Facundo-prog/CPU_sin_procesador/documentation/circuit diagram.pdf

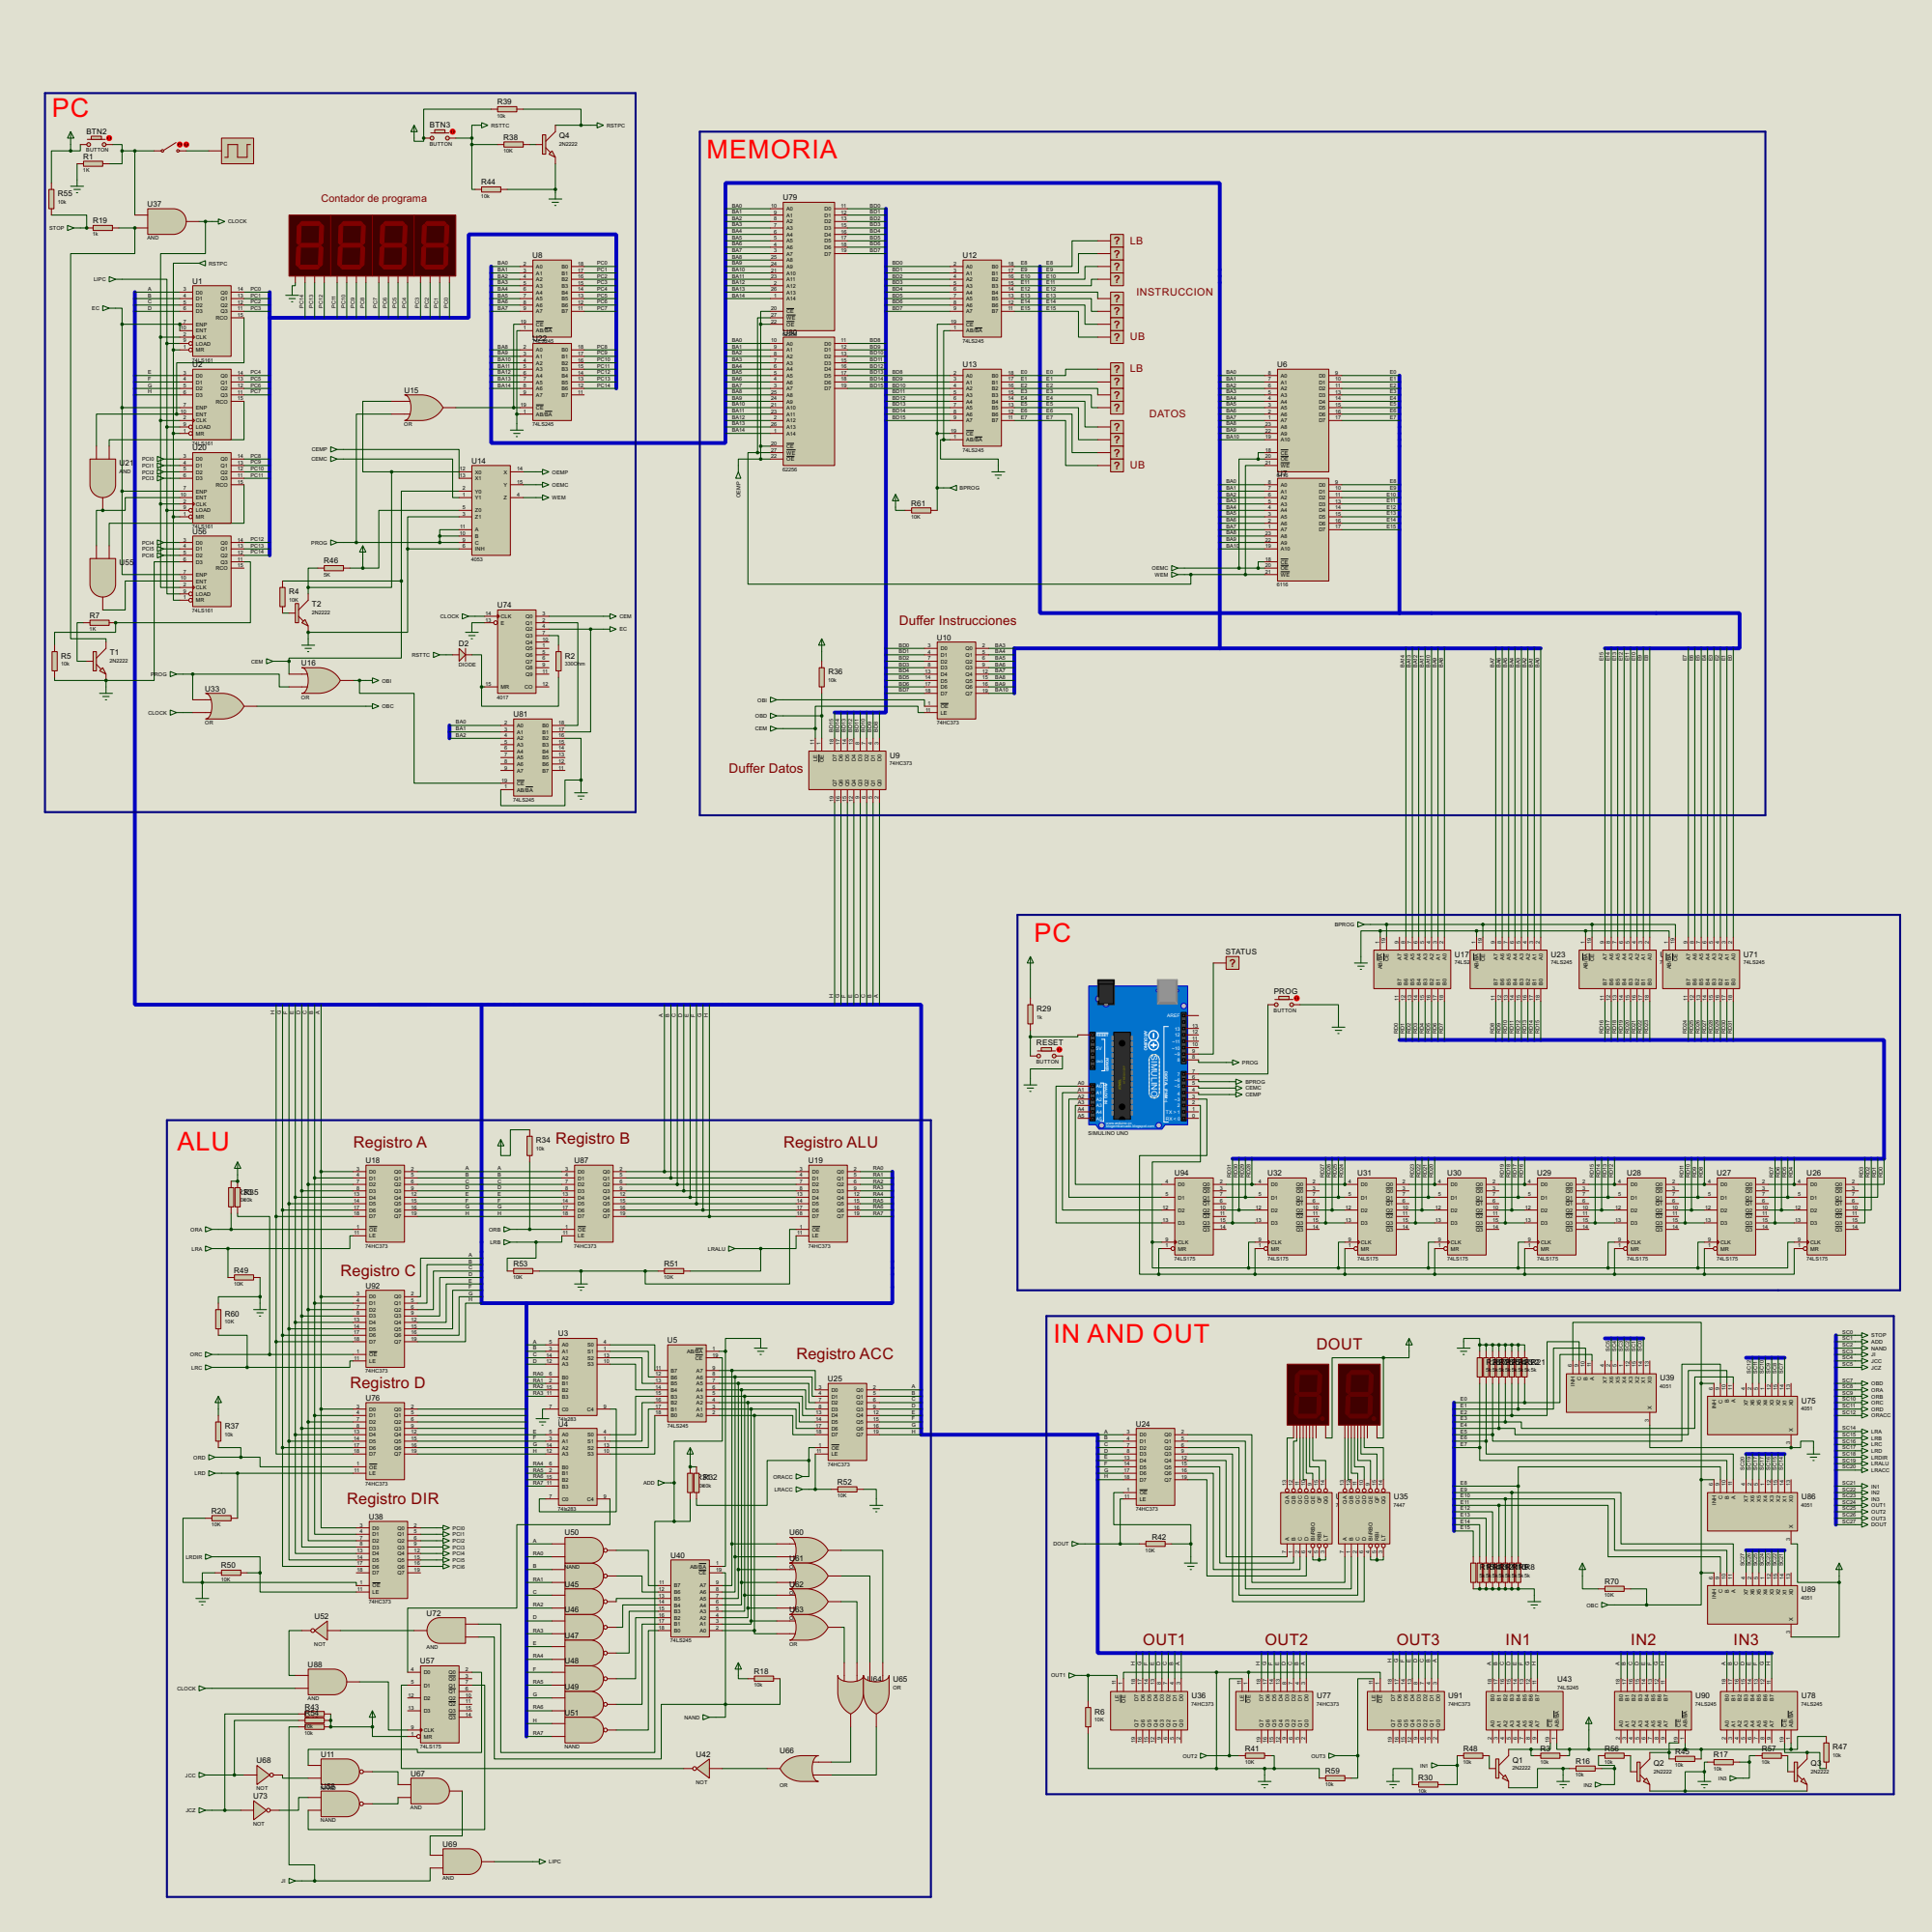
[picture p4: page 1]

www.arduino.cc blogembarcado.blogspot.com

11

OBD
ORA ORB ORACC ORC ORD
