Facundo-prog/CPU_sin_procesador/documentation/instrucctions list.pdf

## Juego de Instrucciones CPU6.0

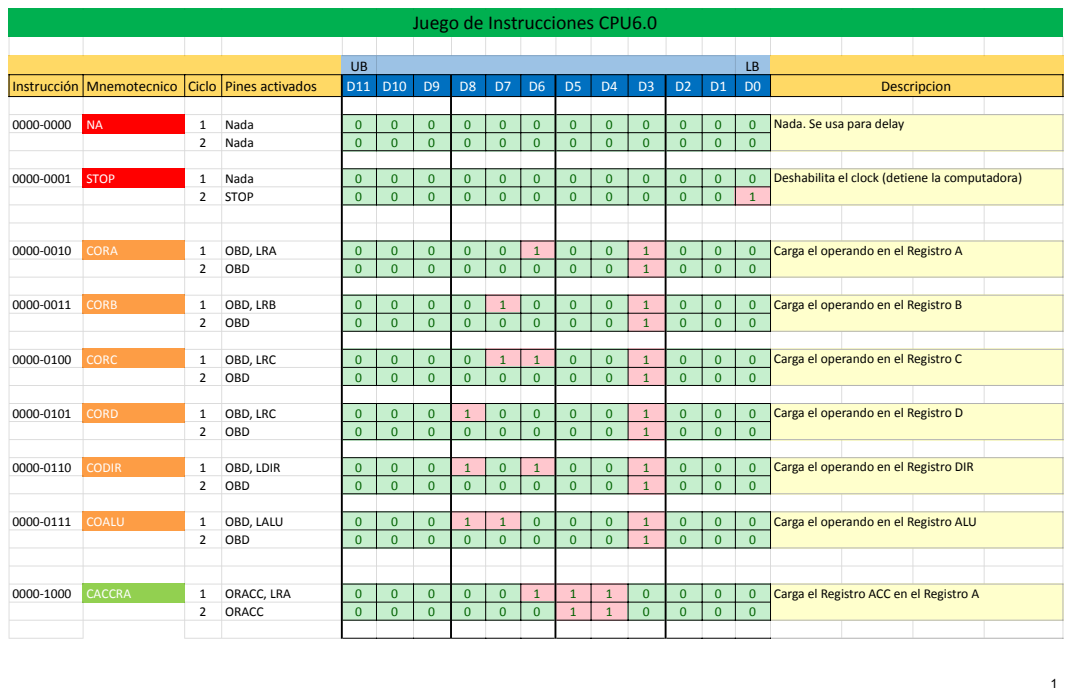
[picture p5: page 1]

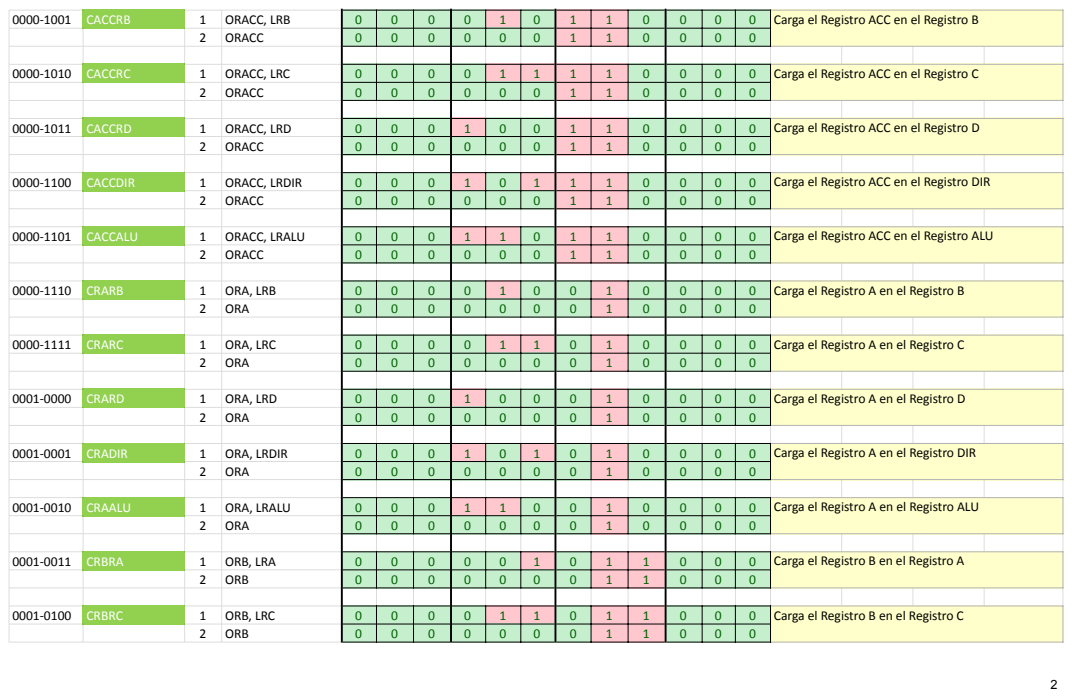
[picture p6: page 2]
0000-1001 CACCRB; ORACC, LRB; Carga el Registro ACC en el Registro B; ORACC; 0000-1010 CACCRC; ORACC, LRC; Carga el Registro ACC en el Registro C; 0000-1011 CACCRD; ORACC, LRD; Carga el Registro ACC en el Registro D; 0000-1100 CACCDIR; ORACC, LRDIR; Carga el Registro ACC en el Registro DIR; 0000-1101 CACCALU; ORACC, LRALU; Carga el Registro ACC en el Registro ALU; 0000-1110 CRARB; ORA, LRB; Carga el Registro A en el Registro B; ORA; 0000-1111 CRARC; ORA, LRC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

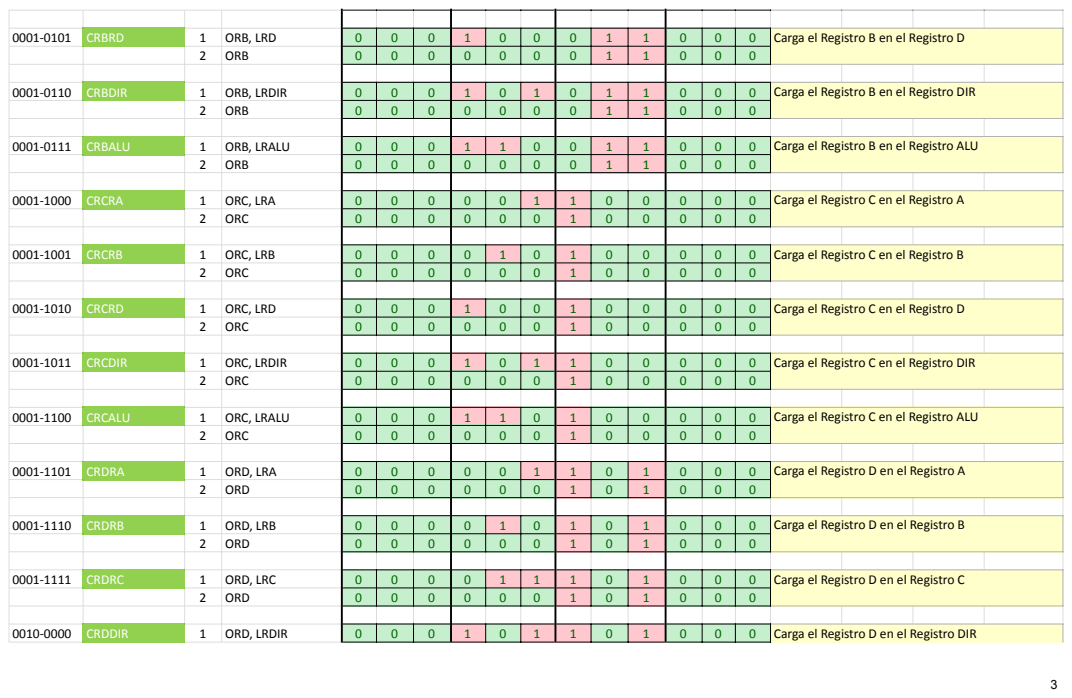
[picture p7: page 3]
0001-0101 CRBRD; ORB, LRD; Carga el Registro B en el Registro D; ORB; 0001-0110 CRBDIR; ORB, LRDIR; Carga el Registro B en el Registro DIR; 0001-0111 CRBALU; ORB, LRALU; Carga el Registro B en el Registro ALU; 0001-1000 CRCRA; ORC, LRA; Carga el Registro C en el Registro A; ORC; 0001-1001 CRCRB; ORC, LRB; Carga el Registro C en el Registro B; 0001-1010 CRCRD; ORC, LRD; Carga el Registro C en el Registro D; 0001-1011 CRCDIR; ORC, LRDIR; Carga el Registro C en el Registro DIR; 0001-1100 CRCALU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

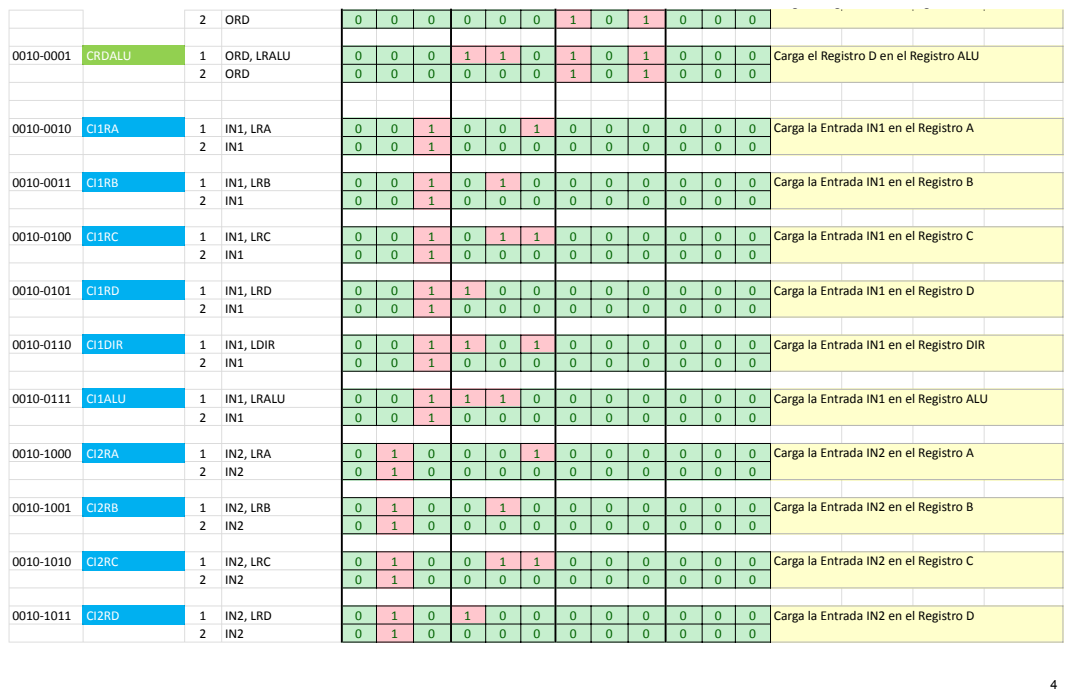
[picture p8: page 4]
ORD; 0010-0001 CRDALU; ORD, LRALU; Carga el Registro D en el Registro ALU; IN1, LRA; Carga la Entrada IN1 en el Registro A; IN1, LRB; Carga la Entrada IN1 en el Registro B; IN1, LRC; Carga la Entrada IN1 en el Registro C; IN1, LRD; Carga la Entrada IN1 en el Registro D; 0010-0110 CI1DIR; IN1, LDIR; Carga la Entrada IN1 en el Registro DIR; 0010-0111 CI1ALU; IN1, LRALU; Carga la Entrada IN1 en el Registro ALU; IN2, LRA; Carga la Entrada IN2 en el Registro A; IN2, LRB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

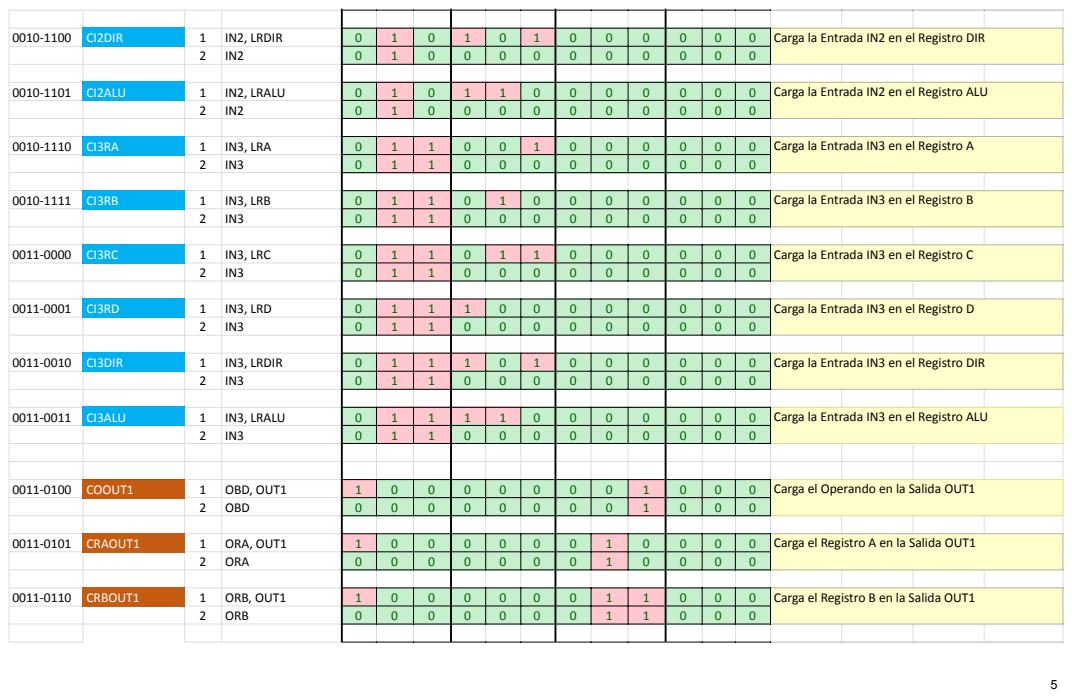
[picture p9: page 5]
0010-1100 CI2DIR; IN2, LRDIR; Carga la Entrada IN2 en el Registro DIR; 0010-1101 CI2ALU; IN2, LRALU; Carga la Entrada IN2 en el Registro ALU; IN3, LRA; Carga la Entrada IN3 en el Registro A; IN3, LRB; Carga la Entrada IN3 en el Registro B; IN3, LRC; Carga la Entrada IN3 en el Registro C; IN3, LRD; Carga la Entrada IN3 en el Registro D; 0011-0010 CI3DIR; IN3, LRDIR; Carga la Entrada IN3 en el Registro DIR; 0011-0011 CI3ALU; IN3, LRALU; Carga la Entrada IN3 en el Registro ALU; 0011-0100 COOUT1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

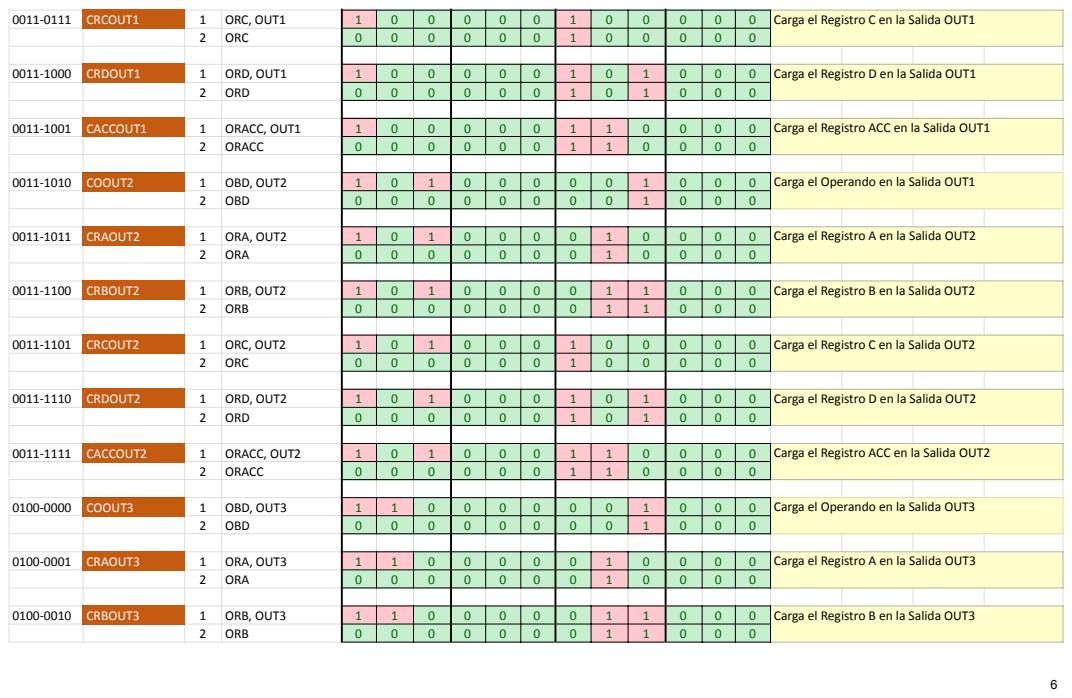
[picture p10: page 6]
0011-0111 CRCOUT1; ORC, OUT1; Carga el Registro C en la Salida OUT1; ORC; 0011-1000 CRDOUT1; ORD, OUT1; Carga el Registro D en la Salida OUT1; ORD; 0011-1001 CACCOUT1; ORACC, OUT1; Carga el Registro ACC en la Salida OUT1; ORACC; 0011-1010 COOUT2; OBD, OUT2; Carga el Operando en la Salida OUT1; OBD; 0011-1011 CRAOUT2; ORA, OUT2; Carga el Registro A en la Salida OUT2; ORA; 0011-1100 CRBOUT2; ORB, OUT2; Carga el Registro B en la Salida OUT2; ORB; 0011-1101 CRCOUT2; ORC, OUT2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

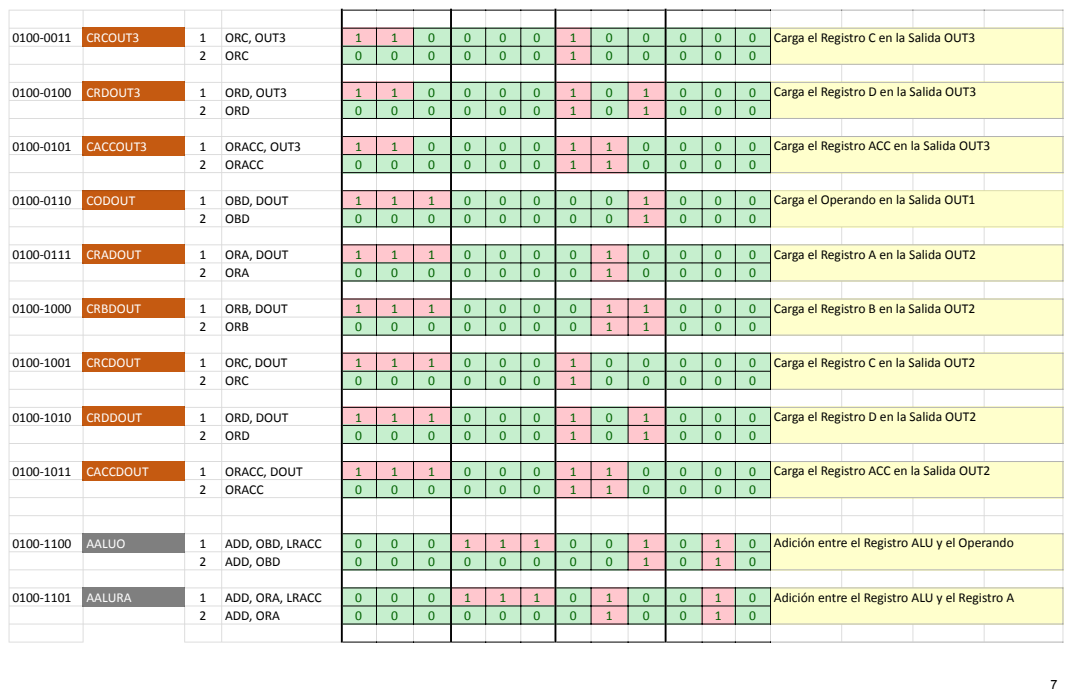
[picture p11: page 7]
0100-0011 CRCOUT3; ORC, OUT3; Carga el Registro C en la Salida OUT3; ORC; 0100-0100 CRDOUT3; ORD, OUT3; Carga el Registro D en la Salida OUT3; ORD; 0100-0101 CACCOUT3; ORACC, OUT3; Carga el Registro ACC en la Salida OUT3; ORACC; 0100-0110 CODOUT; OBD, DOUT; Carga el Operando en la Salida OUT1; OBD; 0100-0111 CRADOUT; ORA, DOUT; Carga el Registro A en la Salida OUT2; ORA; 0100-1000 CRBDOUT; ORB, DOUT; Carga el Registro B en la Salida OUT2; ORB; 0100-1001 CRCDOUT; ORC, DOUT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

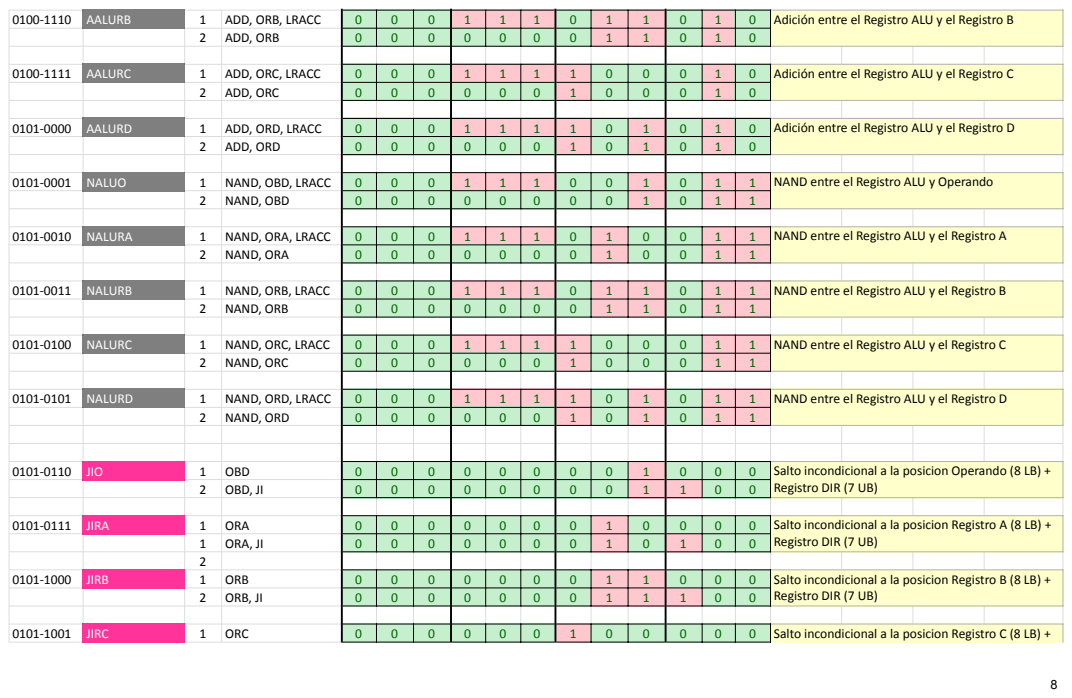
[picture p12: page 8]
0100-1110 AALURB; ADD, ORB, LRACC; Adición entre el Registro ALU y el Registro B; ADD, ORB; 0100-1111 AALURC; ADD, ORC, LRACC; Adición entre el Registro ALU y el Registro C; ADD, ORC; 0101-0000 AALURD; ADD, ORD, LRACC; Adición entre el Registro ALU y el Registro D; ADD, ORD; 0101-0001 NALUO; NAND, OBD, LRACC; NAND entre el Registro ALU y Operando; NAND, OBD; 0101-0010 NALURA; NAND, ORA, LRACC; NAND entre el Registro ALU y el Registro A; NAND, ORA; 0101-0011 NALURB; NAND, ORB, LRACC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

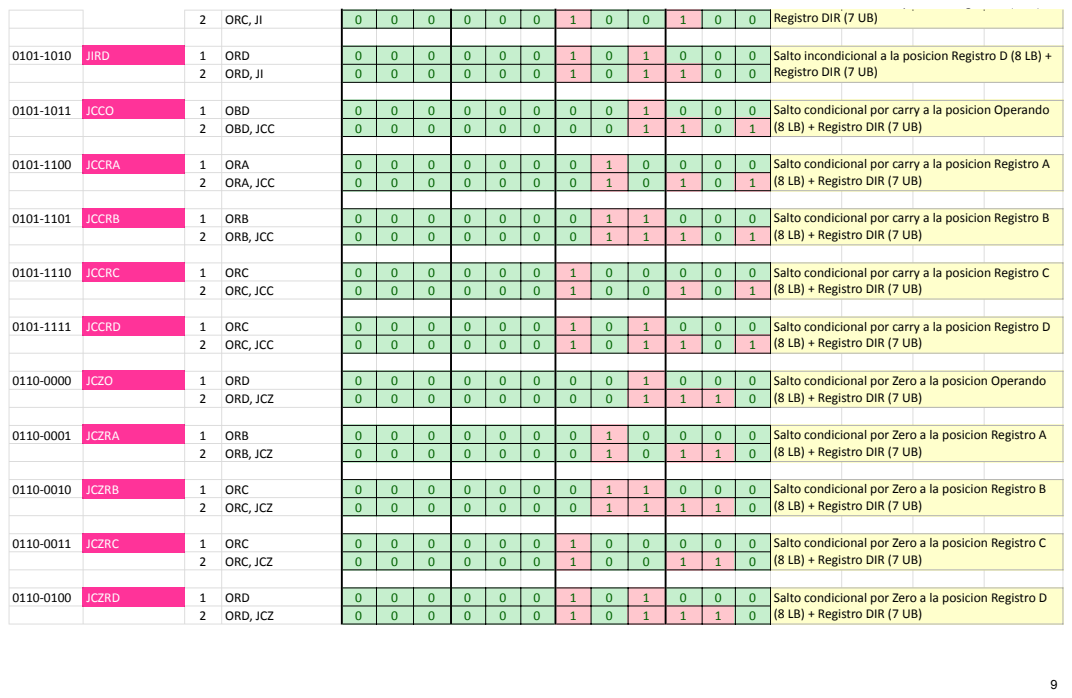
[picture p13: page 9]
ORC, JI; 0101-1010 JIRD; ORD; Salto incondicional a la posicion Registro D (8 LB) +; ORD, JI; Registro DIR (7 UB); 0101-1011 JCCO; OBD; Salto condicional por carry a la posicion Operando; OBD, JCC; (8 LB) + Registro DIR (7 UB); 0101-1100 JCCRA; ORA; Salto condicional por carry a la posicion Registro A; ORA, JCC; 0101-1101 JCCRB; ORB; Salto condicional por carry a la posicion Registro B; ORB, JCC; 0101-1110 JCCRC; ORC; Salto condicional por carry a la posicion Registro C; ORC, JCC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

Registro DIR (7 UB)
